robertbedichek/ampservos/docs/collar.png

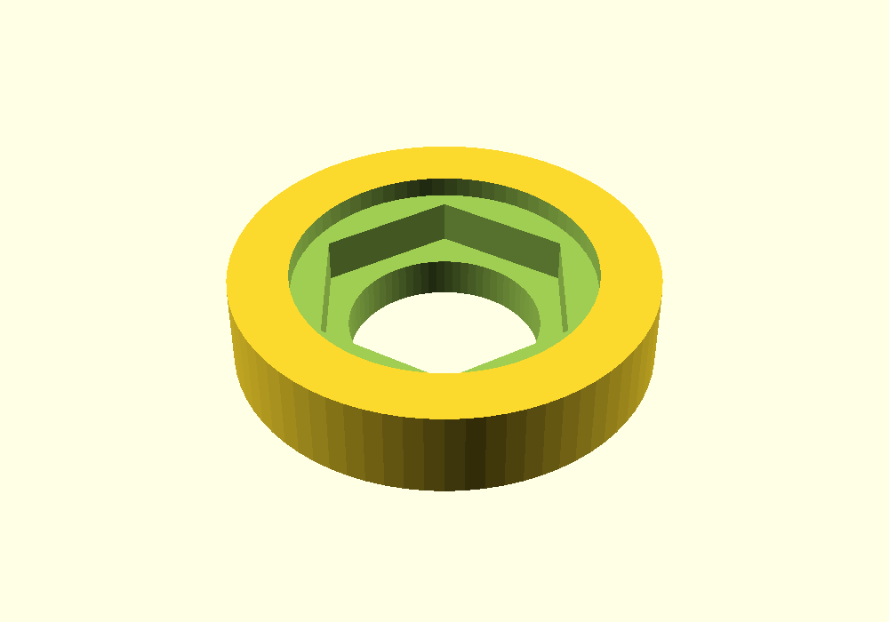
docs/collar.png
