robertbedichek/ampservos/docs/collar_section.png

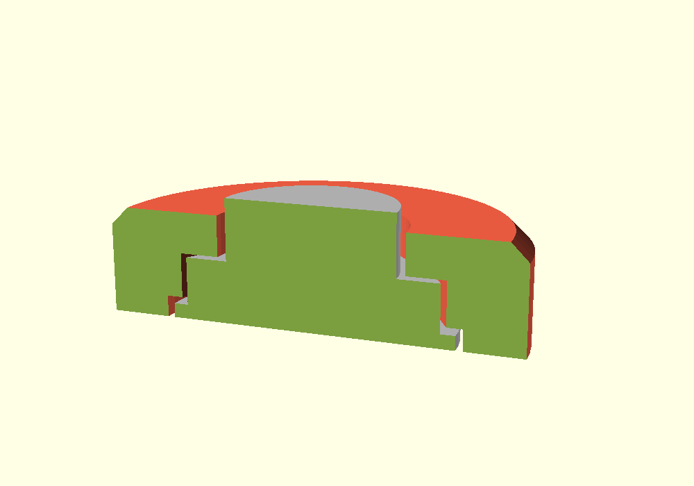
docs/collar_section.png
