robertbedichek/ampservos/docs/coupler_exploded.png

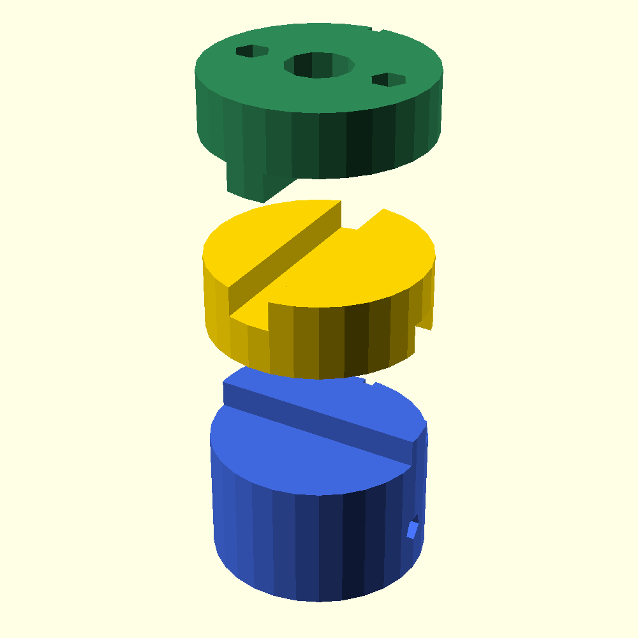
docs/coupler_exploded.png
