robertbedichek/ampservos/docs/coupler_set.png

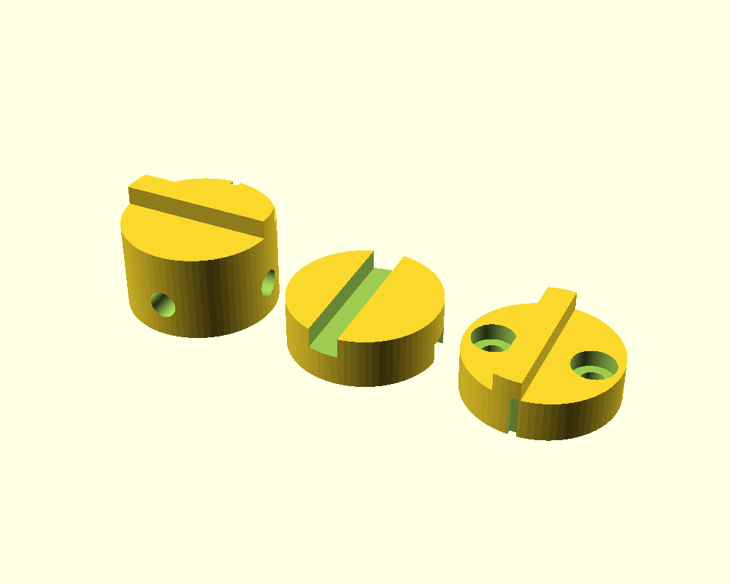
docs/coupler_set.png
