robertbedichek/ampservos/docs/couplers.png

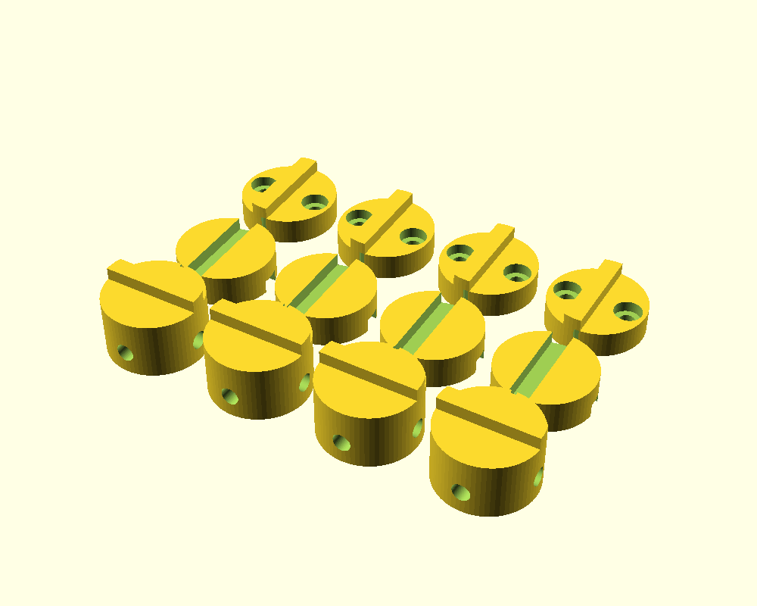
docs/couplers.png
