robertbedichek/ampservos/docs/coupon.png

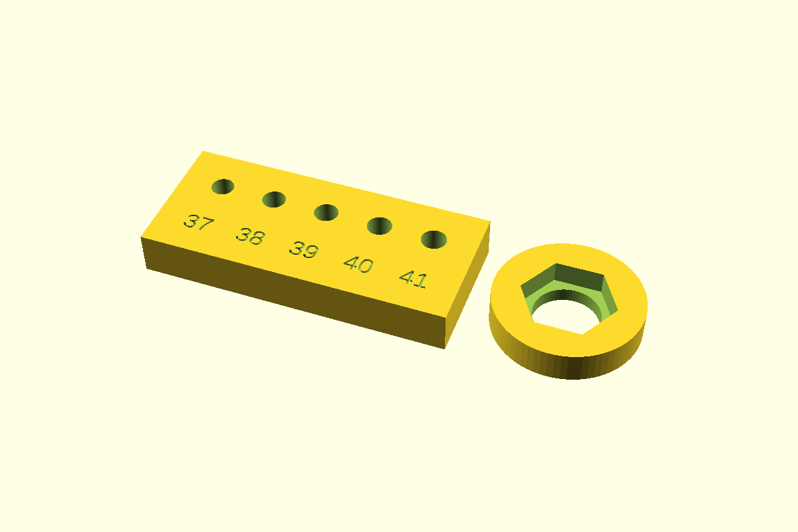
docs/coupon.png
