robertbedichek/ampservos/docs/coupon_bottom.png

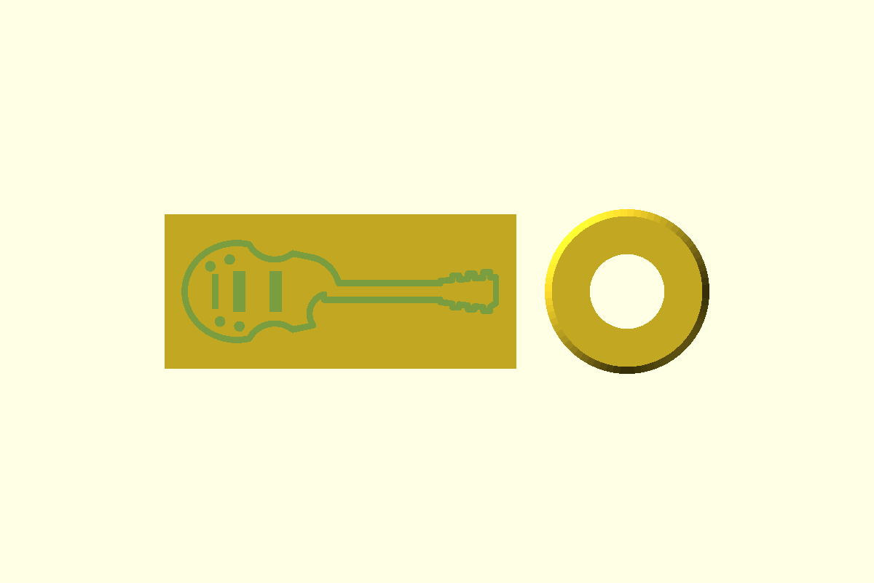
docs/coupon_bottom.png
