robertbedichek/ampservos/docs/ear_grooves.png

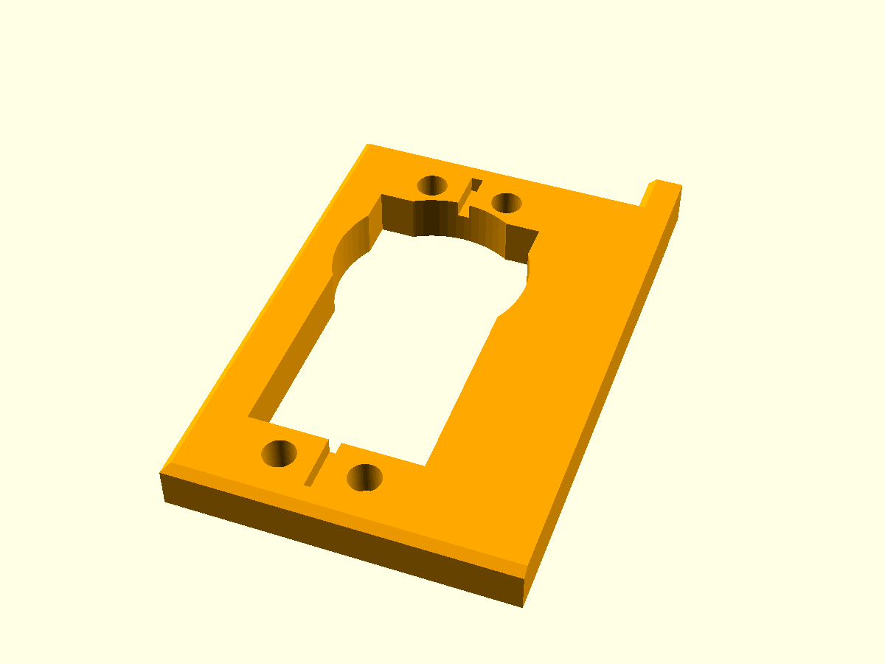
docs/ear_grooves.png
