robertbedichek/ampservos/docs/frame.png

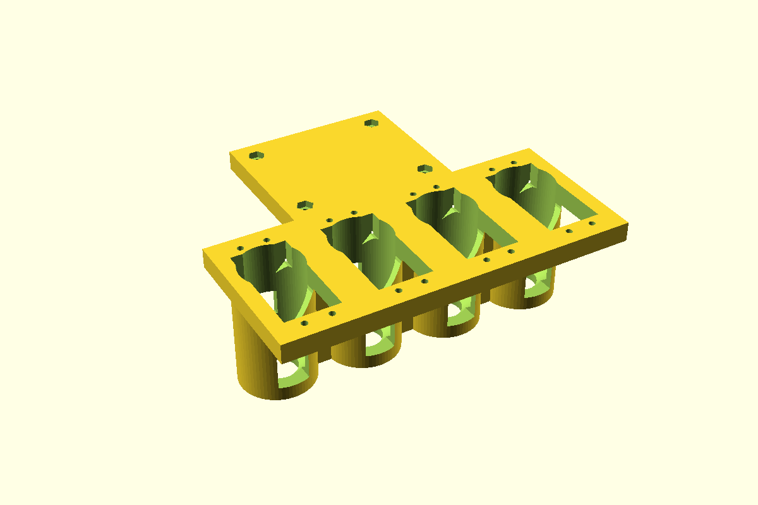
docs/frame.png
