robertbedichek/ampservos/docs/frame_section.png

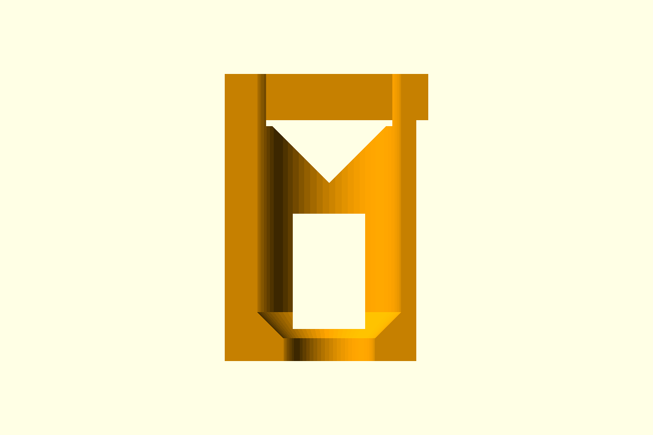
docs/frame_section.png
