robertbedichek/ampservos/docs/frame_use_bottom.png

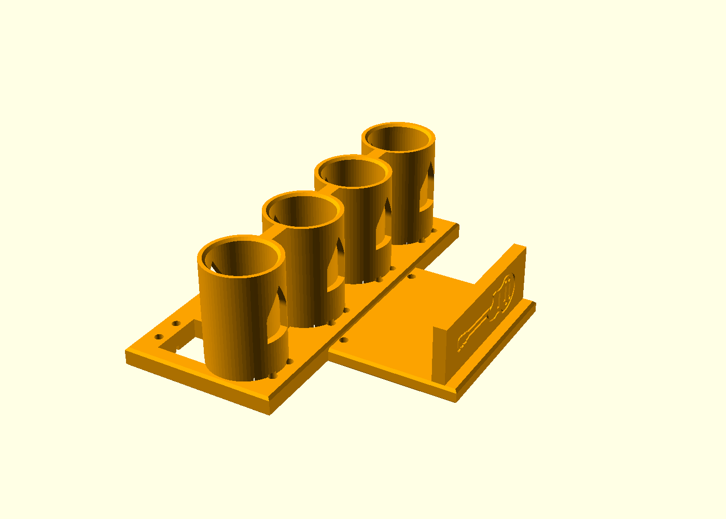
docs/frame_use_bottom.png
