robertbedichek/ampservos/docs/frame_use_top.png

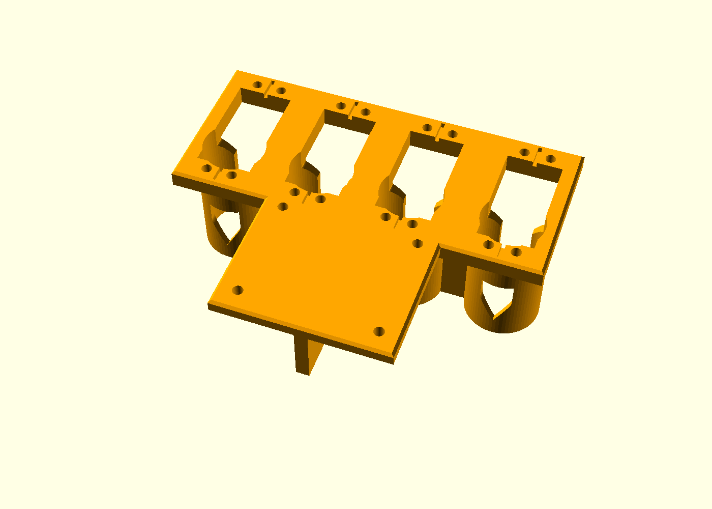
docs/frame_use_top.png
