robertbedichek/ampservos/docs/hub_pot.png

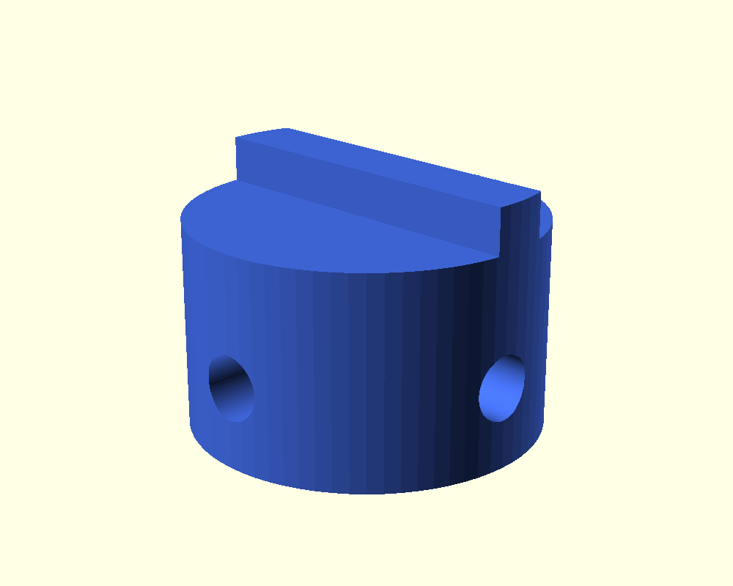
docs/hub_pot.png
