robertbedichek/ampservos/docs/hub_pot_cut.png

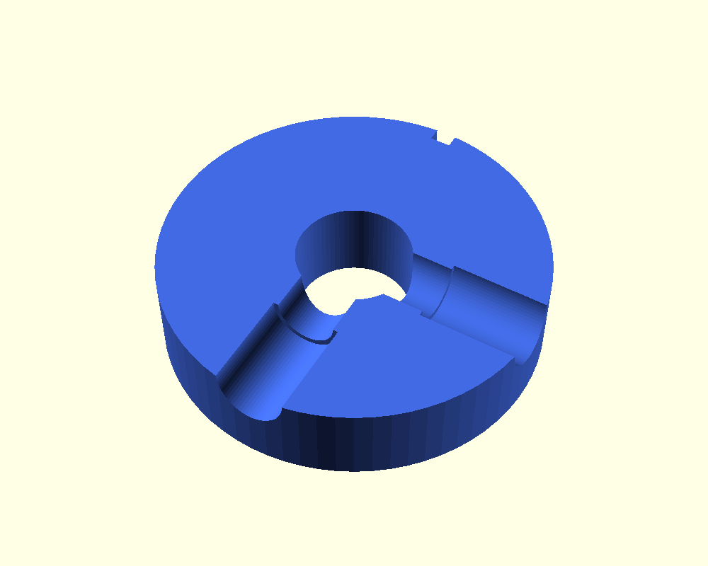
docs/hub_pot_cut.png
