robertbedichek/ampservos/docs/hub_pot_section.png

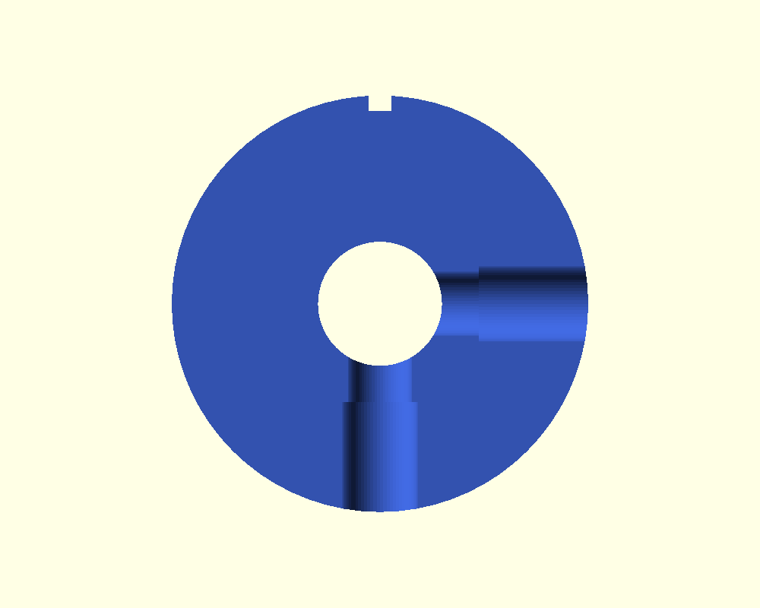
docs/hub_pot_section.png
