robertbedichek/ampservos/docs/lift_off.png

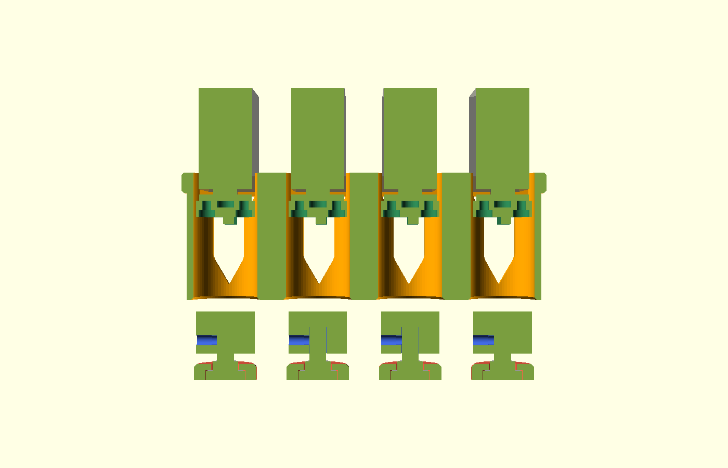
docs/lift_off.png
