robertbedichek/ampservos/docs/ridge_section.png

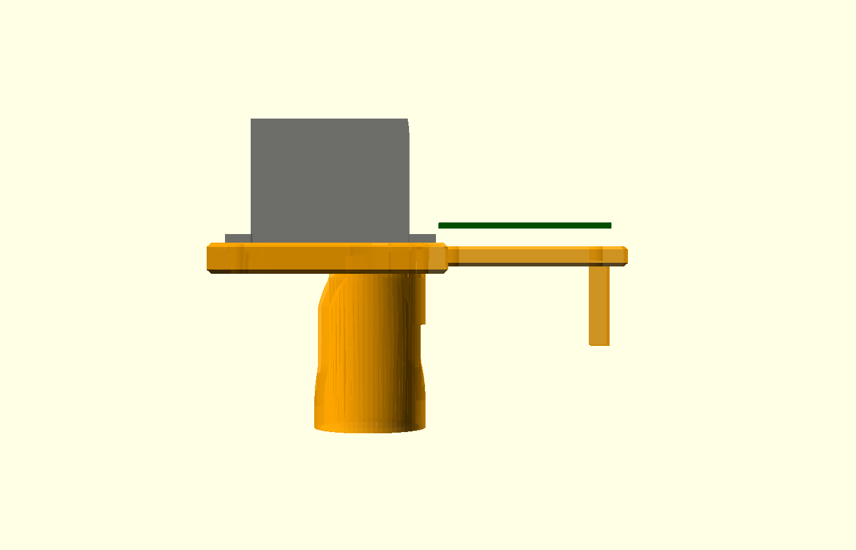
docs/ridge_section.png
