robertbedichek/ampservos/docs/seated_section.png

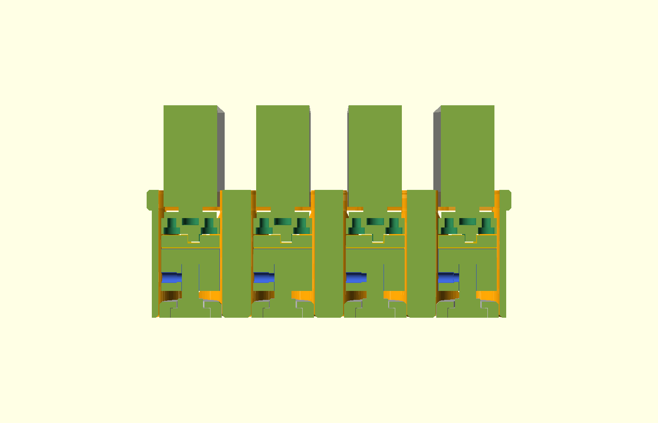
docs/seated_section.png
