robertbedichek/ampservos/docs/stud_section.png

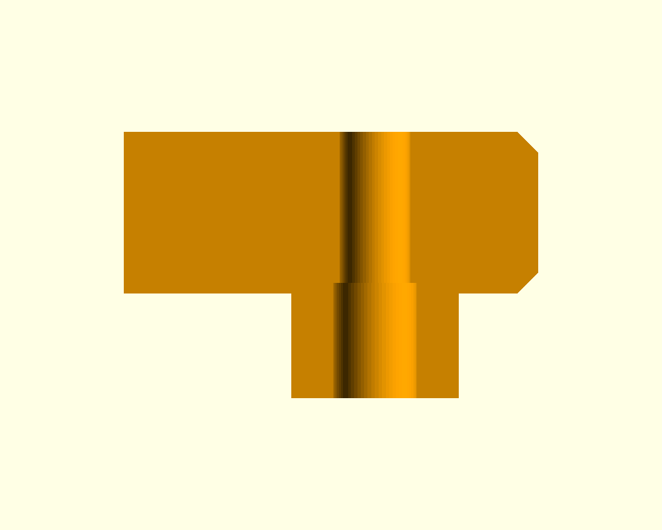
docs/stud_section.png
