robertbedichek/ampservos/plates/ampservo-plate.3mf

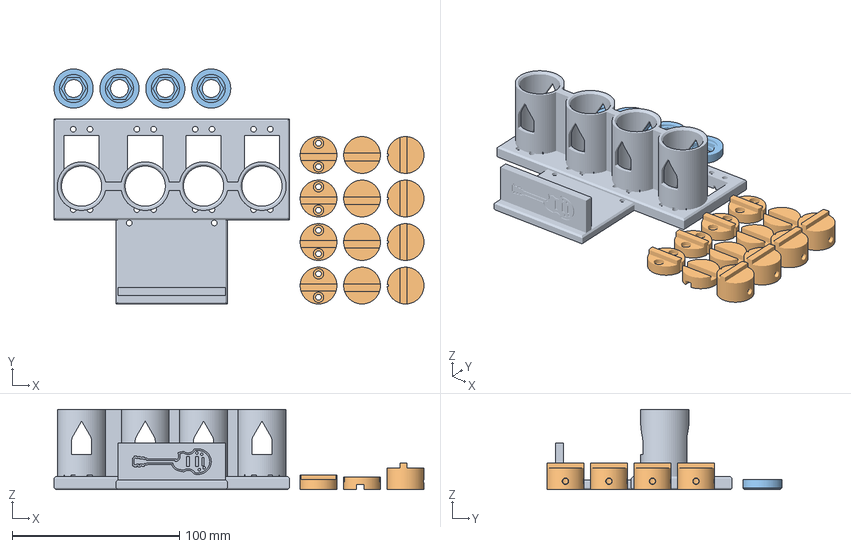
[picture p22: CAD file, 2026-10-26]
plates/ampservo-plate.3mf
221.0 x 140.5 x 47.9 mm
frame
couplers
collars
