robertbedichek/ampservos/stl/frame.stl

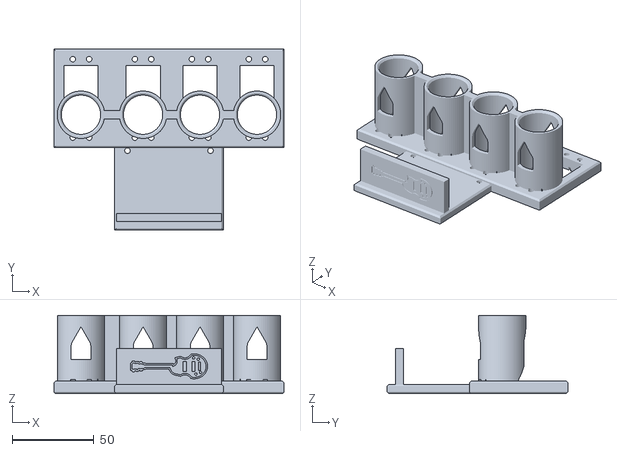
[picture p23: CAD file, 2026-10-26]
stl/frame.stl
140.7 x 110.6 x 47.9
