robertbedichek/ampservos/stl/test_station.stl

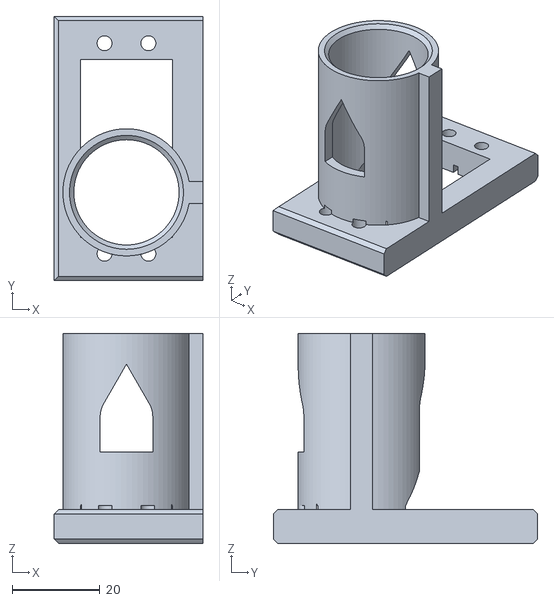
[picture p24: CAD file, 2026-10-26]
stl/test_station.stl
33.9 x 60.3 x 47.9
