robertbedichek/ampservos/stl/collars.stl

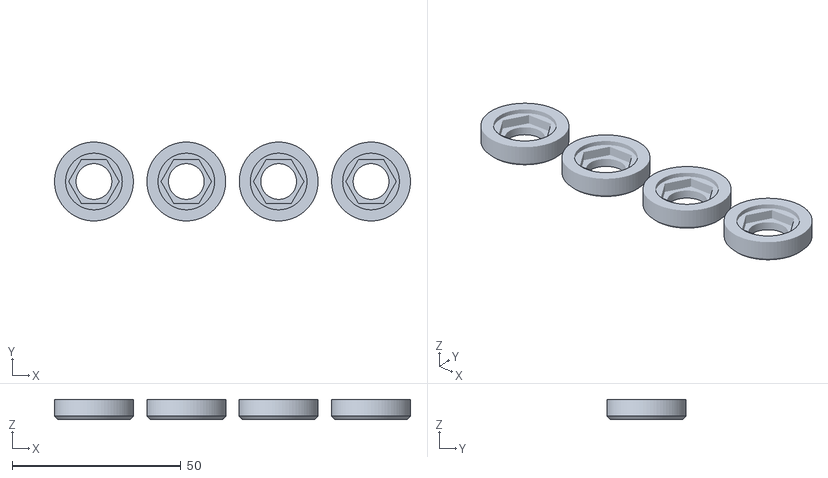
[picture p25: CAD file, 2026-10-25]
stl/collars.stl
105.6 x 23.4 x 6.00
