robertbedichek/ampservos/stl/collar.stl

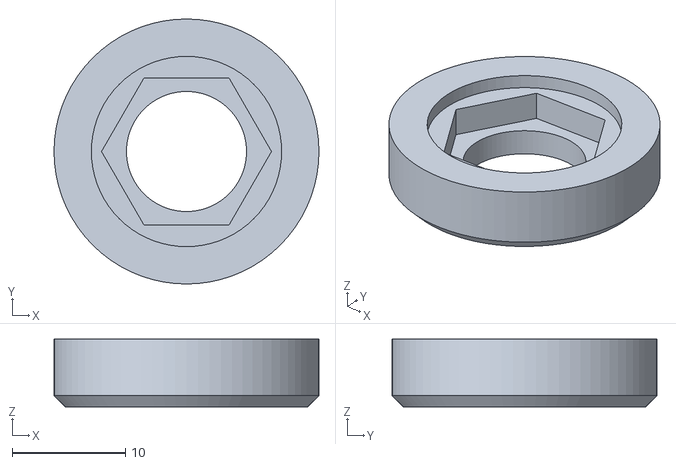
[picture p26: CAD file, 2026-10-25]
stl/collar.stl
23.4 x 23.4 x 6.00
