robertbedichek/ampservos/stl/coupon.stl

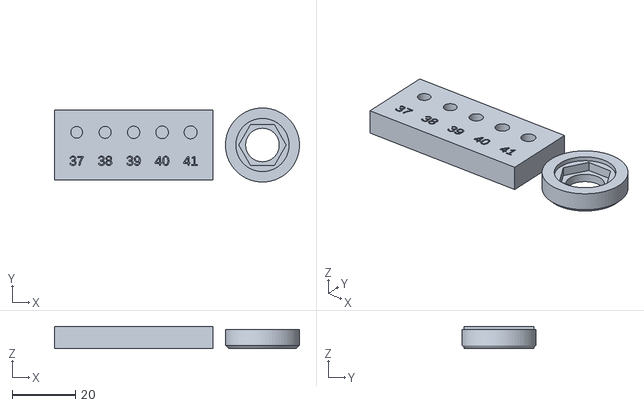
[picture p27: CAD file, 2026-10-25]
stl/coupon.stl
77.4 x 23.4 x 7.00
