robertbedichek/ampservos/stl/coupler_set.stl

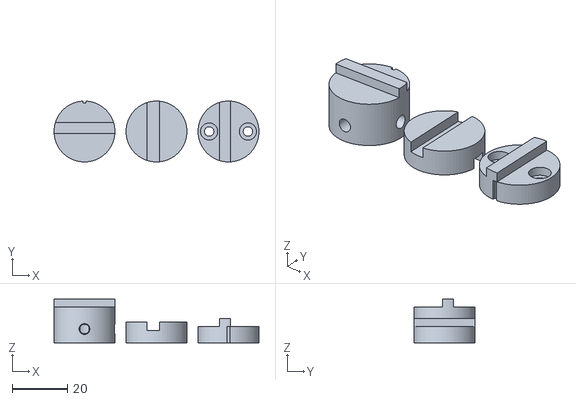
[picture p28: CAD file, 2026-10-25]
stl/coupler_set.stl
74.0 x 22.0 x 15.8
