robertbedichek/ampservos/stl/couplers.stl

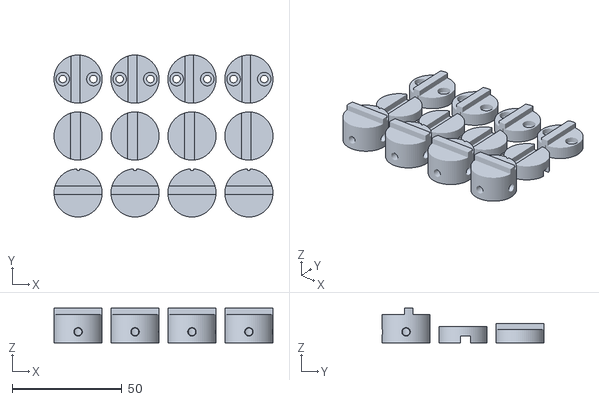
[picture p29: CAD file, 2026-10-25]
stl/couplers.stl
100.0 x 74.0 x 15.8
