robertbedichek/ampservos/docs/assembly_below.png

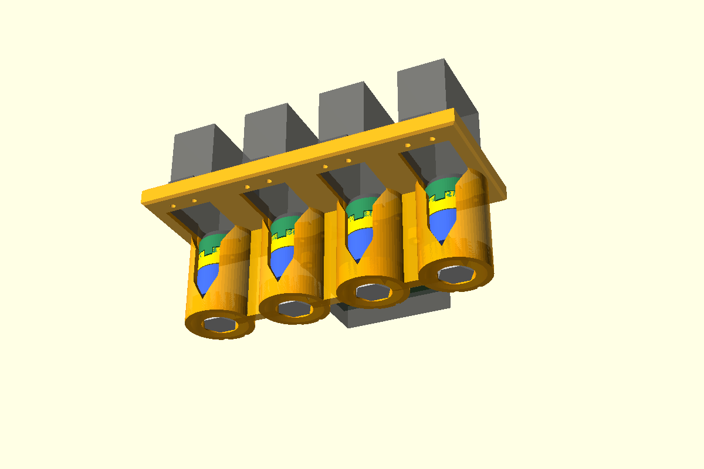
docs/assembly_below.png
