robertbedichek/ampservos/docs/assembly_board.png

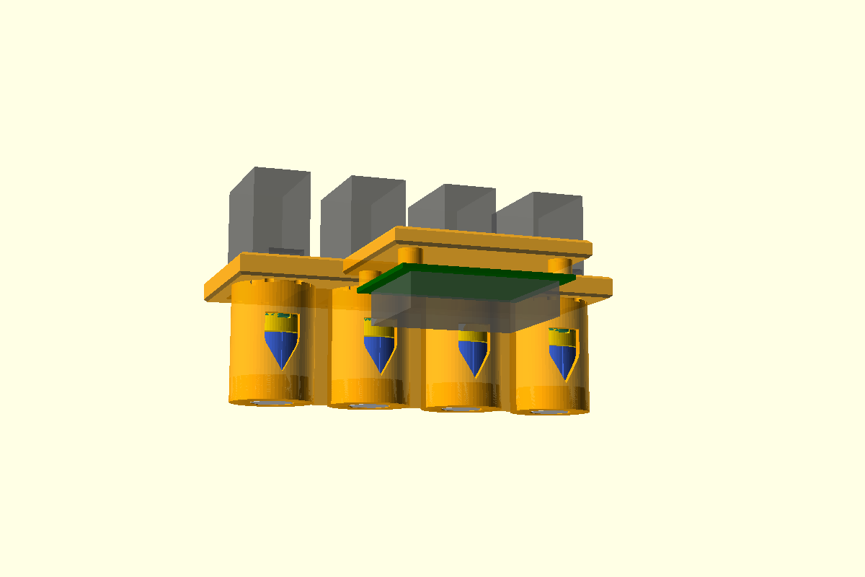
docs/assembly_board.png
