robertbedichek/ampservos/docs/assembly_front.png

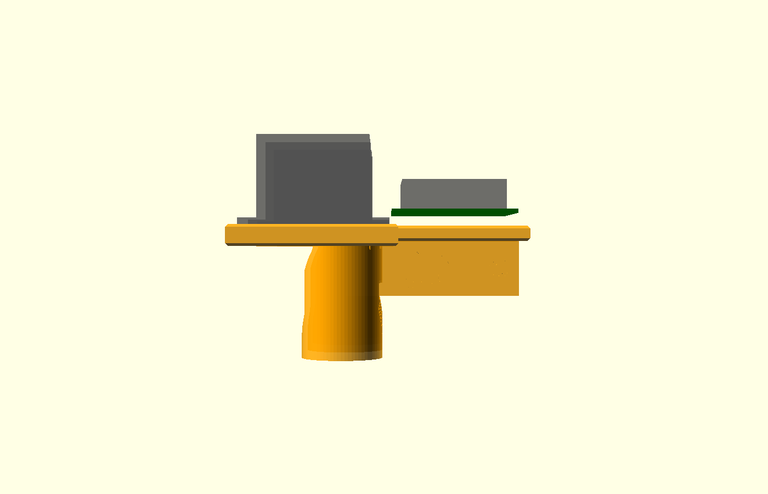
docs/assembly_front.png
