robertbedichek/ampservos/docs/frame_print.png

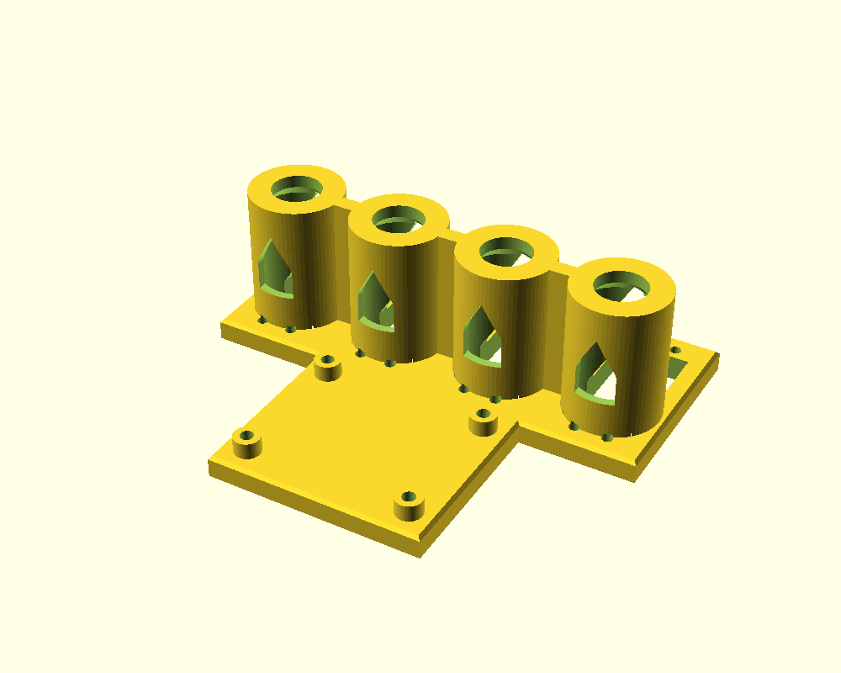
docs/frame_print.png
