robertbedichek/ampservos/docs/insert_test.png

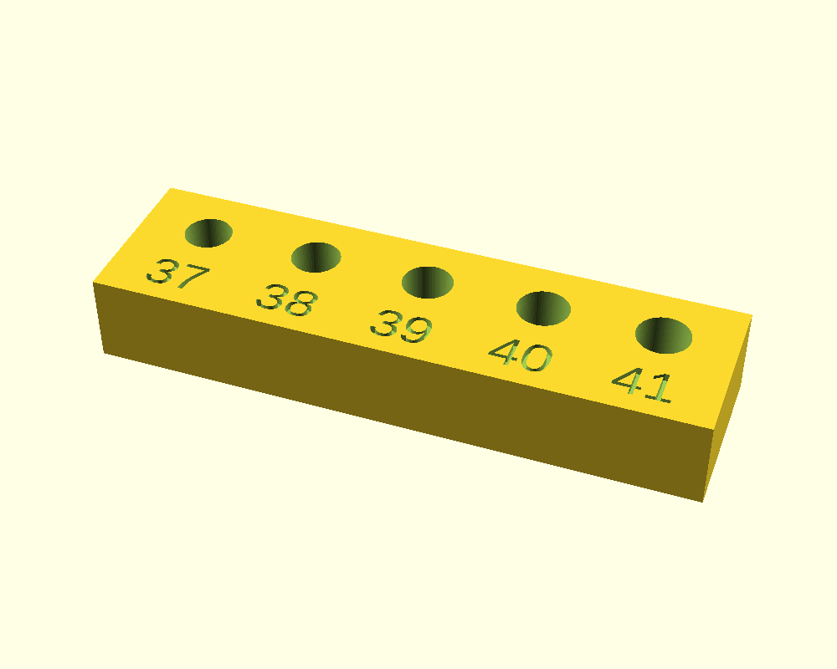
docs/insert_test.png
