robertbedichek/ampservos/docs/test_station.png

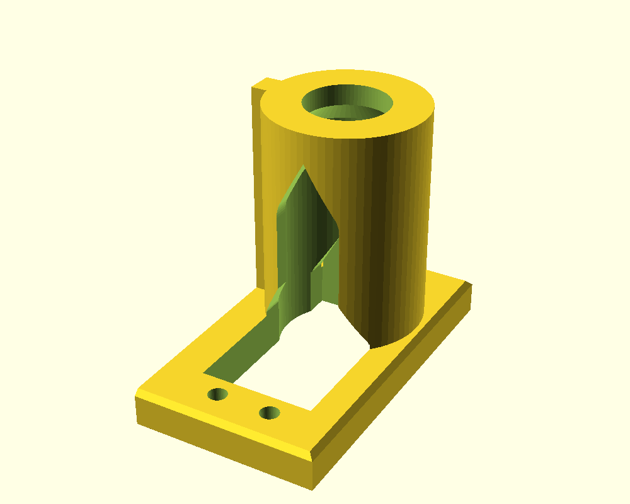
docs/test_station.png
