robertbedichek/ampservos/docs/test_station_section.png

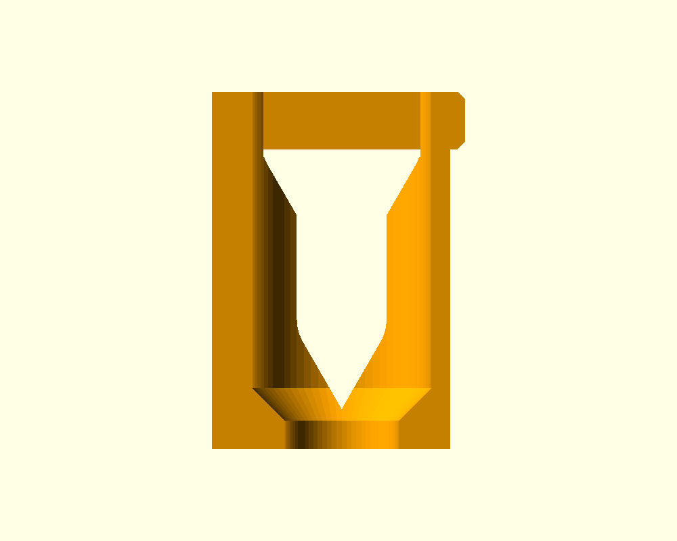
docs/test_station_section.png
