robertbedichek/ampservos/docs/test_station_use_board_side.png

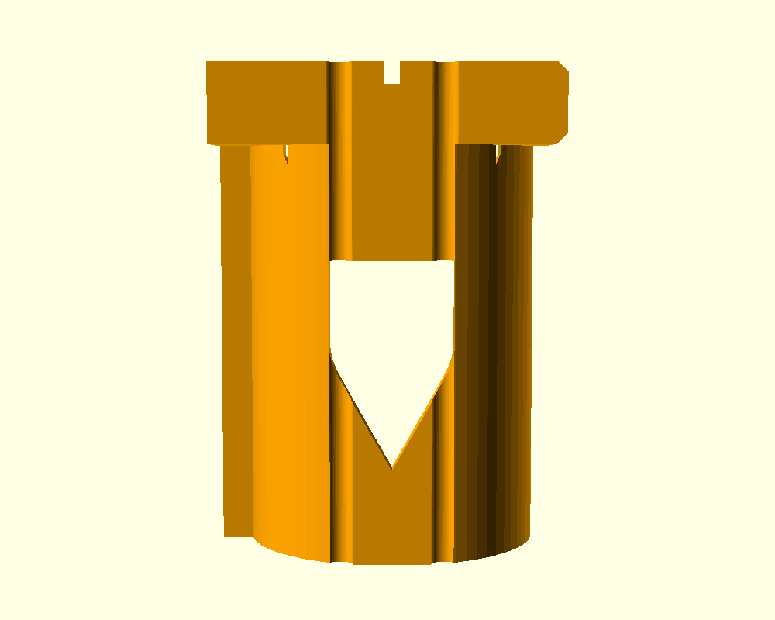
docs/test_station_use_board_side.png
