robertbedichek/ampservos/docs/test_station_use_bottom.png

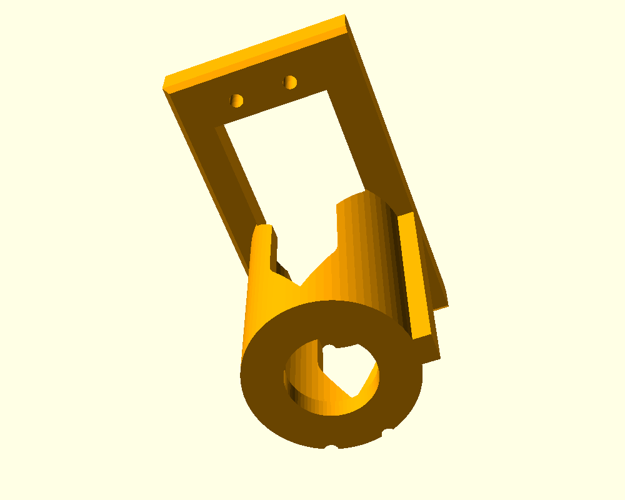
docs/test_station_use_bottom.png
