robertbedichek/ampservos/docs/test_station_use_servo_side.png

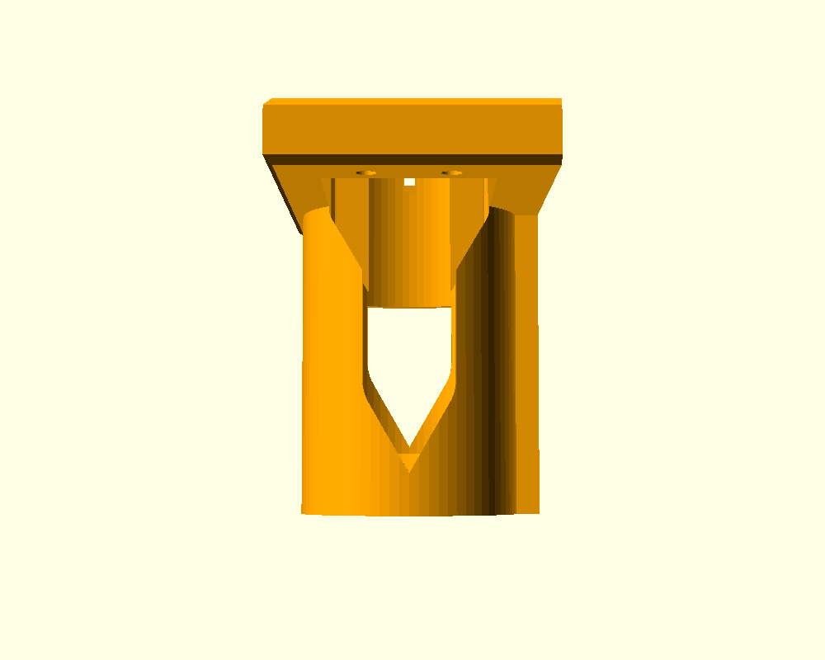
docs/test_station_use_servo_side.png
