robertbedichek/ampservos/docs/test_station_use_top.png

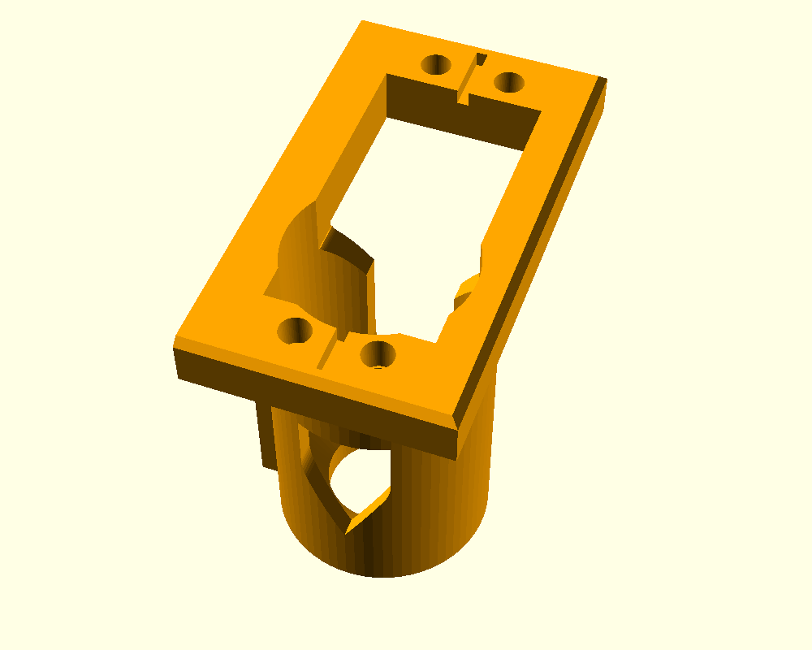
docs/test_station_use_top.png
