robertbedichek/ampservos/(commit log)

2026-10-24 Initial four-servo knob actuator: OpenSCAD frame/couplers, Phidgets control script
    [amp_servo_mount.scad, couplers.stl, frame.stl]
2026-10-24 Fix nut pocket being cut away by tube bore; add render views
    [amp_servo_mount.scad, frame.stl]
2026-10-24 Add parts list to README; servo dims from goBILDA drawing
    [amp_servo_mount.scad, couplers.stl, frame.stl]
2026-10-24 README: where to buy the 300-degree goBILDA servo
2026-10-24 Support the older 1061 AdvancedServo 8-Motor controller
2026-10-24 Set measured shaft pitch: 1.366" (34.70 mm)
    [amp_servo_mount.scad, couplers.stl, frame.stl]
2026-10-24 Add 1061 board shelf with studs; use servo's included horn and screws
    [amp_servo_mount.scad, frame.stl]
2026-10-24 Use 19.8 mm aluminum horn (M3 tapped, 14 mm circle); widen couplers to 22 mm; board renders
    [amp_servo_mount.scad, couplers.stl, frame.stl]
2026-10-24 Keyed Oldham couplers, pointer grooves on hubs, --park command and refit procedure
    [amp_servo_mount.scad, couplers.stl]
2026-10-24 Printability: tongues on hubs and slots in disc, nut-seat cone, servo pocket floor, thicker plate; test station and coupler set parts
    [amp_servo_mount.scad, coupler_set.stl, couplers.stl, frame.stl, test_station.stl]
2026-10-24 Slicer settings in repo; full frame and coupler renders
2026-10-24 Servo opening through the plate with a 45-degree gable instead of a bridged floor
    The 1.2 mm pocket floor printed as a ragged 21 mm bridge, and its 21 mm width
    kept a servo with the 22 mm coupler hub attached from dropping in.
    [amp_servo_mount.scad, frame.stl, test_station.stl]
2026-10-25 Grooves for the gussets under the servo ears
    [amp_servo_mount.scad, frame.stl, test_station.stl]
2026-10-25 Set-screw slot runs up into the servo opening instead of a 45-degree V; 1.5 mm ear-gusset grooves
    [amp_servo_mount.scad, frame.stl, test_station.stl]
2026-10-25 1.5 mm ear-gusset grooves; pointed 45-degree slot ends instead of flat bridges
    [amp_servo_mount.scad, frame.stl, test_station.stl]
2026-10-25 Refresh frame and assembly renders
2026-10-25 Teardrop slot ends and rounded flare at 60 degrees; chamfer plate edges
    45-degree overhangs printed rough in PETG on the 2.5 mm tube walls.
    [amp_servo_mount.scad, frame.stl, test_station.stl]
2026-10-25 Brass heat-set inserts: M3 at the servo ears, board studs and pot-hub set screws; insert sizing coupon
    [amp_servo_mount.scad, coupler_set.stl, couplers.stl, frame.stl, insert_test.stl, test_station.stl]
2026-10-25 Pot hub: two set screws 90 degrees apart in heat-set inserts; couplers sliced solid
    [amp_servo_mount.scad, coupler_set.stl, couplers.stl]
2026-10-25 Nut collars instead of nut pockets, so the frame lifts off over the pot hubs; board shelf 2 mm thinner
    [amp_servo_mount.scad, collars.stl, frame.stl, test_station.stl]
2026-10-25 Guitar logo engraved in the board shelf; combined coupon with insert holes, logo and a nut collar
    [amp_servo_mount.scad, coupon.stl, frame.stl, insert_test.stl]
2026-10-25 Insert holes 3.9 mm, from the coupon
    [amp_servo_mount.scad, coupler_set.stl, couplers.stl, frame.stl, test_station.stl]
2026-10-25 Collar: recess for the 16 mm washer under the pot nut; nut measured 12.45 mm across flats
    [amp_servo_mount.scad, collar.stl, collars.stl, coupon.stl]
2026-10-26 Reverb 38.0 mm from Bass, others 34.85 mm; 1061 on top of a 5 mm shorter shelf; stiffening ridge under it carries the logo
    [amp_servo_mount.scad, frame.stl, test_station.stl]
2026-10-26 Ridge parallel to the row of servos; ear-gusset grooves 1 mm shorter, ending at the ear tips
    [amp_servo_mount.scad, frame.stl, test_station.stl]
2026-10-26 Ridge 5 mm in from the shelf's outer edge
    [amp_servo_mount.scad, frame.stl]
2026-10-26 One-plate 3MF: frame at 40%, coupler sets and collars solid
    [ampservo-plate.3mf]
2026-10-26 Embed the PETG profile in the plate 3MF
    [ampservo-plate.3mf]
